XiaoHai11111/FlexGrip/4.Images/DCDC-5v.png

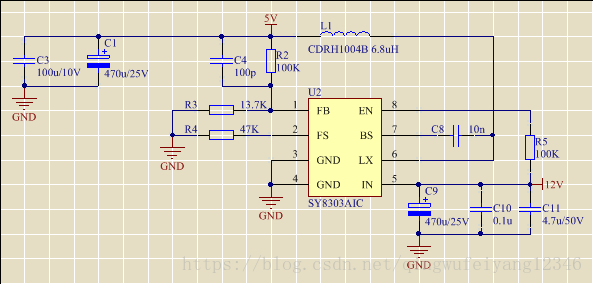
4.Images/DCDC-5v.png
