XiaoHai11111/FlexGrip/4.Images/PCB1.png

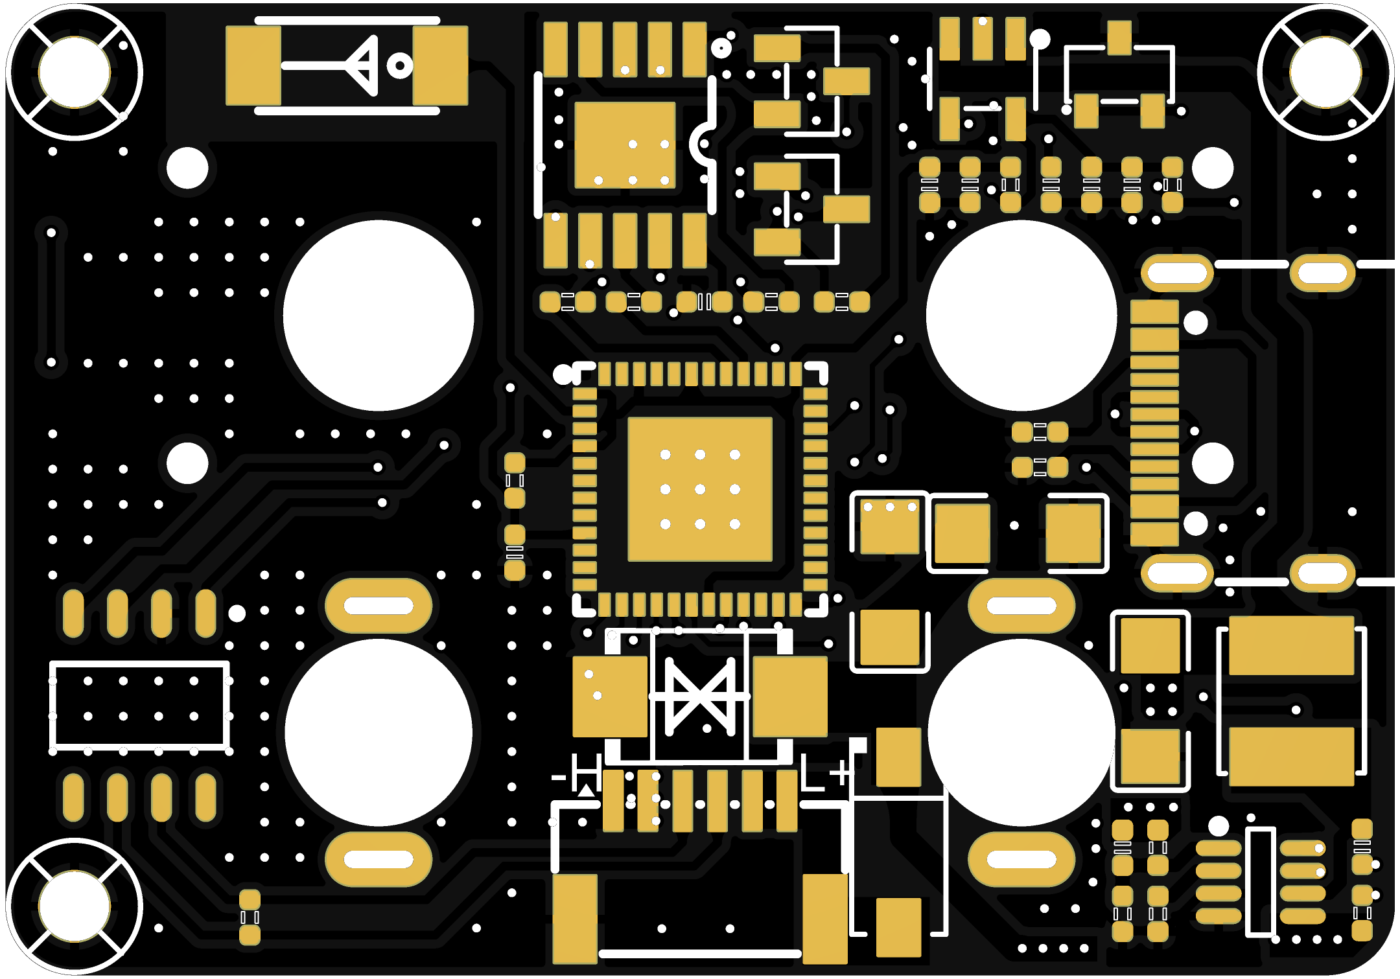
4.Images/PCB1.png
