XiaoHai11111/FlexGrip/4.Images/PCB2.png

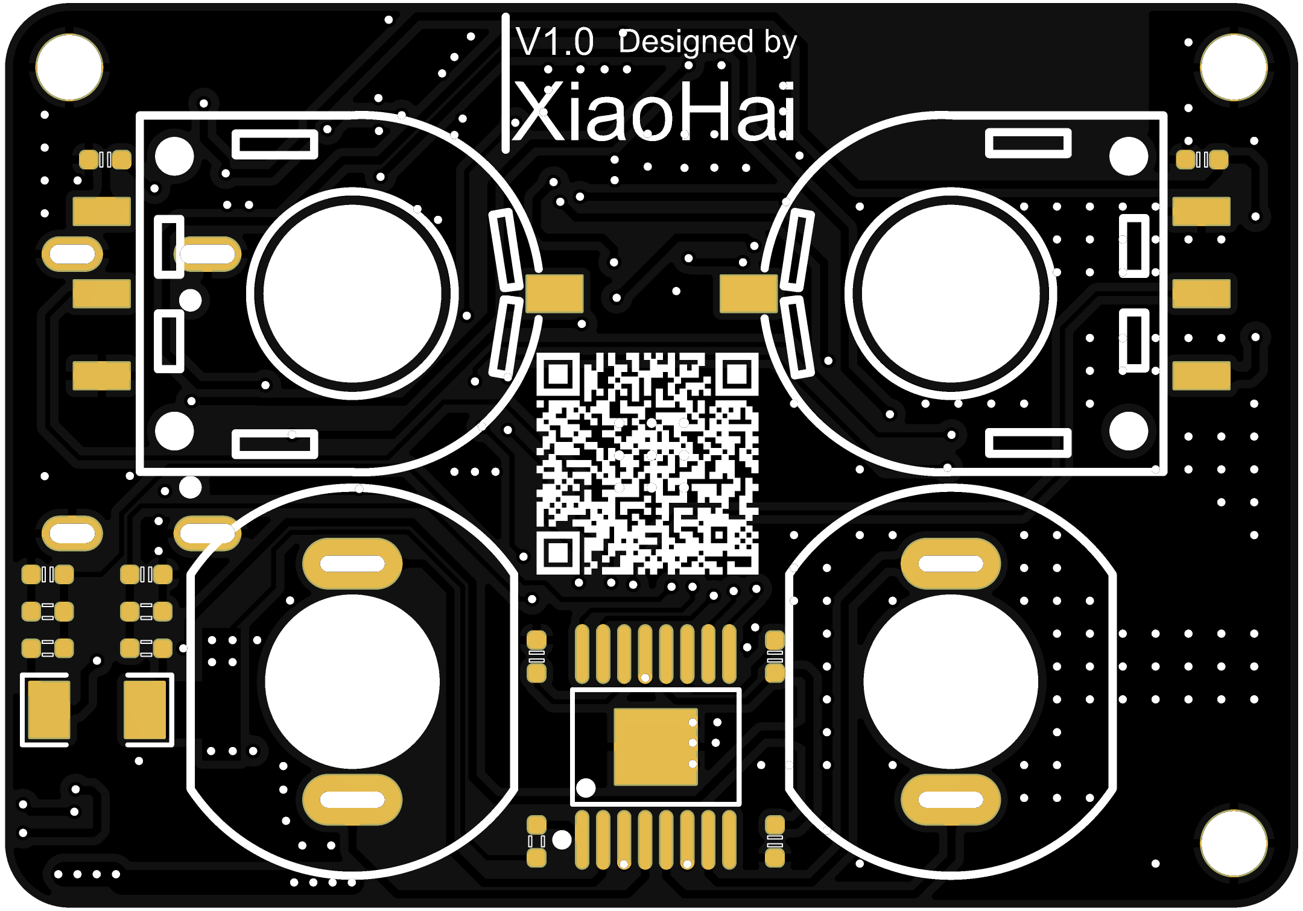
4.Images/PCB2.png
