XiaoHai11111/FlexGrip/1.Model/FlexGrip_URDF/FlexGripper.SLDASM

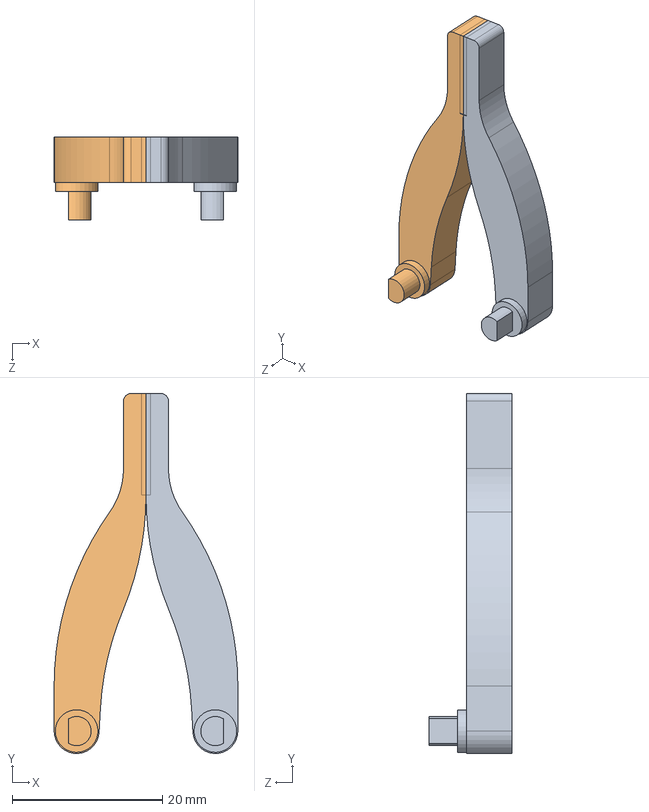
[picture p4: CAD file, 2026-10-30]
1.Model/FlexGrip_URDF/FlexGripper.SLDASM
24.5 x 48.0 x 11.0 mm
FlexGrip_gripper_left
FlexGrip_gripper_right
