XiaoHai11111/FlexGrip/1.Model/FlexGrip_DCBrushedMotor/Self/加工文件/外壳2.STEP

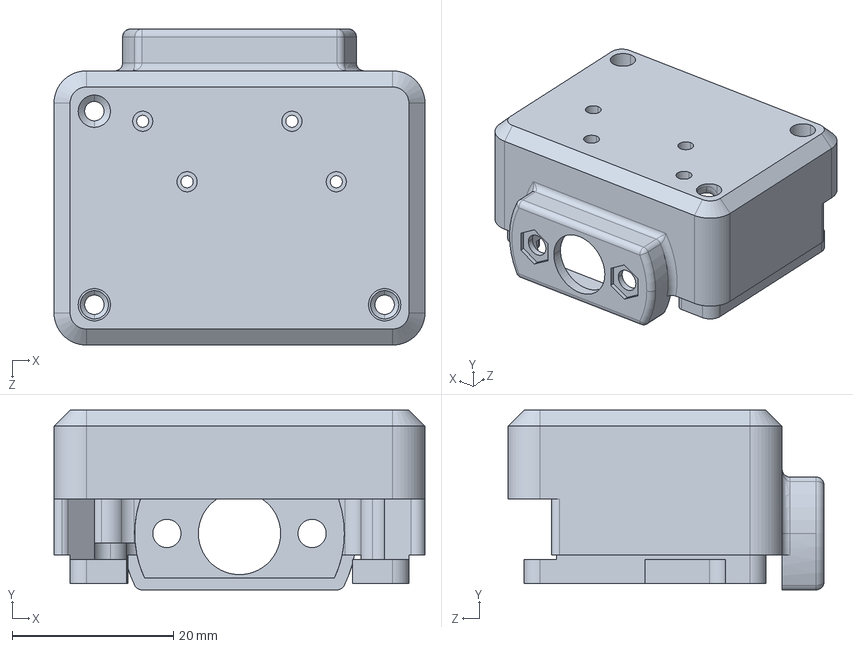
[picture p5: CAD file, 2026-10-30]
1.Model/FlexGrip_DCBrushedMotor/Self/加工文件/外壳2.STEP
46.0 x 22.3 x 39.2 mm
