XiaoHai11111/FlexGrip/1.Model/FlexGrip_URDF/FlexGrip_gripper_right.SLDPRT

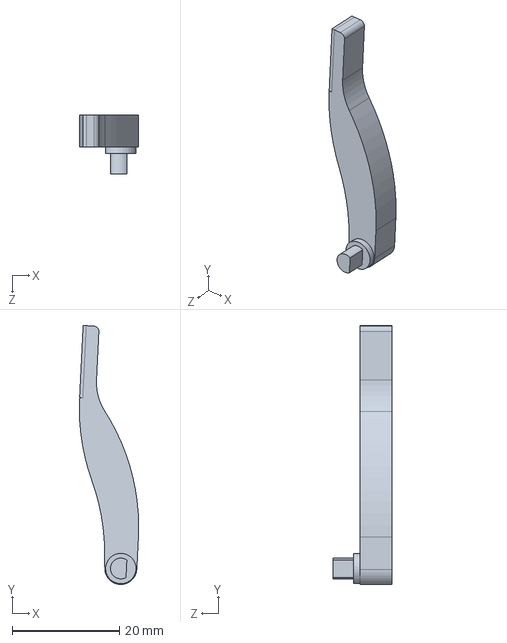
[picture p6: CAD file, 2026-10-30]
1.Model/FlexGrip_URDF/FlexGrip_gripper_right.SLDPRT
11.1 x 48.4 x 11.0 mm
