XiaoHai11111/FlexGrip/6.Software/FlexGripper/meshes/finger_right.STL

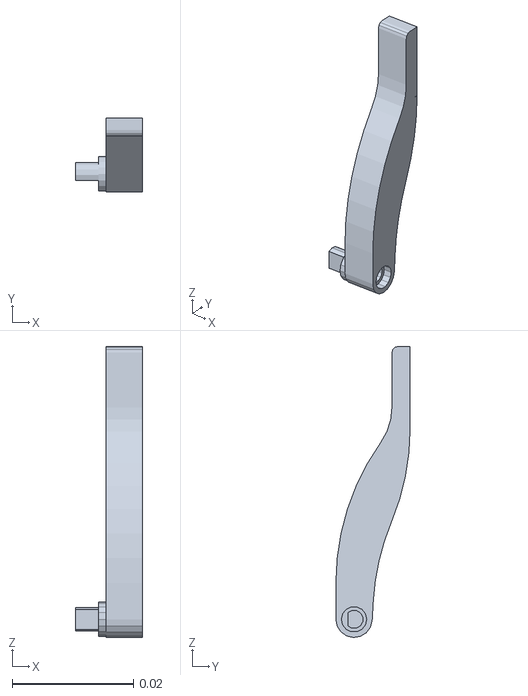
[picture p7: CAD file, 2026-10-30]
6.Software/FlexGripper/meshes/finger_right.STL
0.011 x 0.0123 x 0.048
