XiaoHai11111/FlexGrip/1.Model/FlexGrip_DCBrushedMotor/Self/加工文件/外壳1.STEP

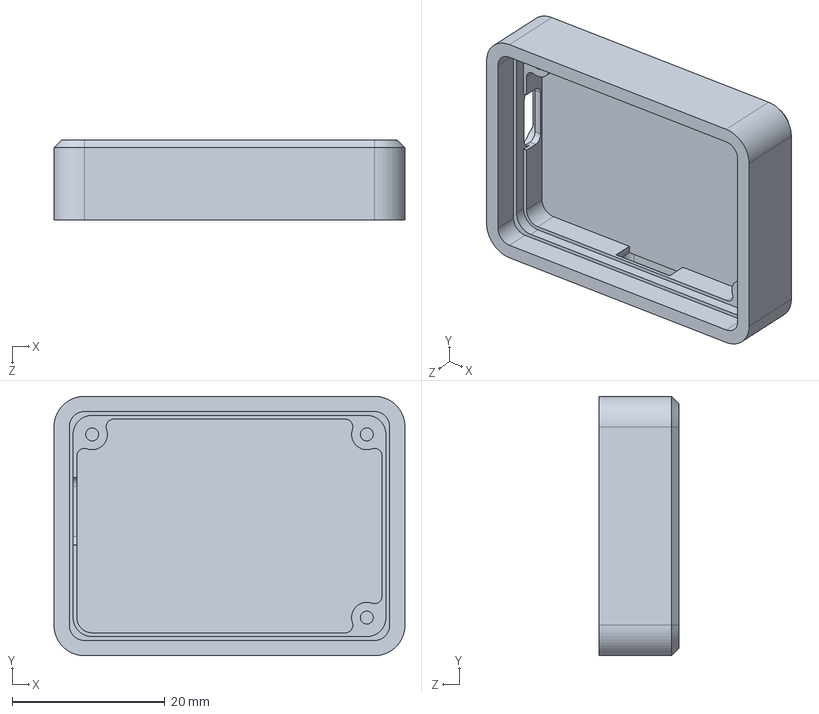
[picture p8: CAD file, 2026-10-30]
1.Model/FlexGrip_DCBrushedMotor/Self/加工文件/外壳1.STEP
46.0 x 34.0 x 10.5 mm
