XiaoHai11111/FlexGrip/1.Model/FlexGrip_DCBrushedMotor/Zhihui/MirrorDCMotor.SLDPRT

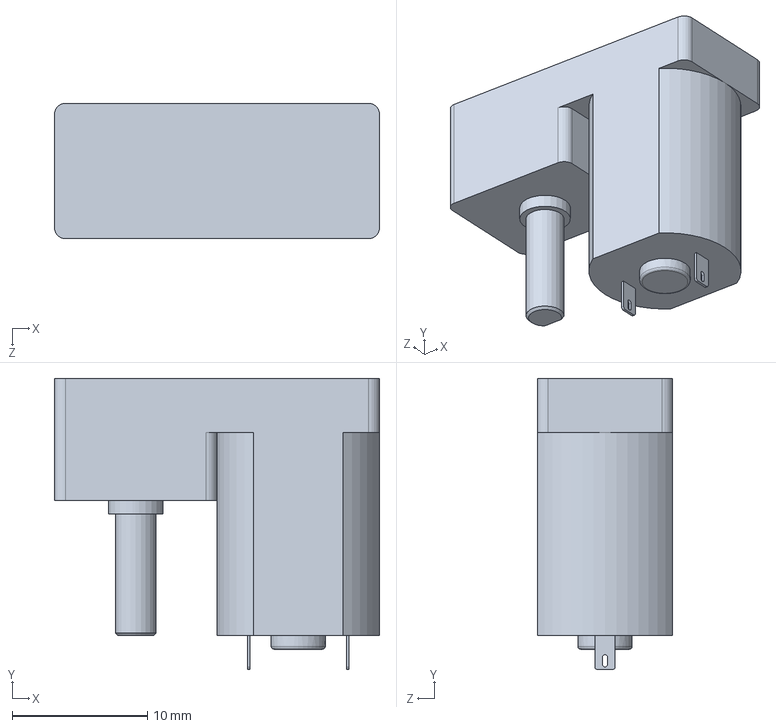
[picture p9: CAD file, 2026-10-30]
1.Model/FlexGrip_DCBrushedMotor/Zhihui/MirrorDCMotor.SLDPRT
24.0 x 21.5 x 10.0 mm
