XiaoHai11111/FlexGrip/6.Software/FlexGripper/meshes/FlexGripper.STL

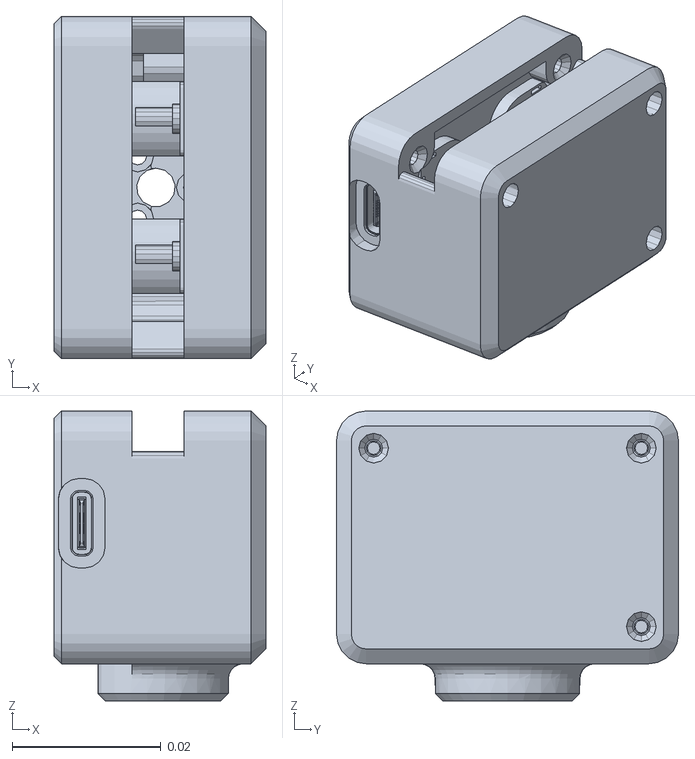
[picture p10: CAD file, 2026-10-30]
6.Software/FlexGripper/meshes/FlexGripper.STL
0.0285 x 0.046 x 0.039
