XiaoHai11111/FlexGrip/1.Model/FlexGrip_URDF/FlexGrip.SLDPRT

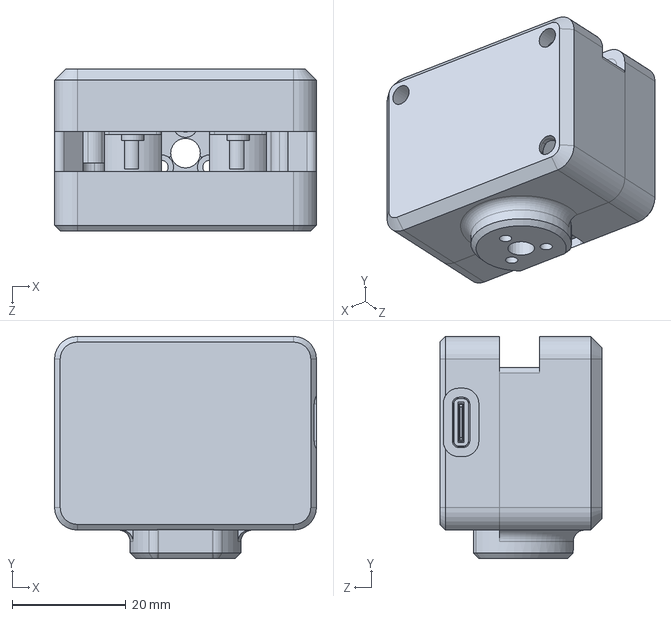
[picture p11: CAD file, 2026-10-30]
1.Model/FlexGrip_URDF/FlexGrip.SLDPRT
46.0 x 39.0 x 28.5 mm
