XiaoHai11111/FlexGrip/1.Model/FlexGrip_DCBrushedMotor/Self/夹爪.SLDPRT

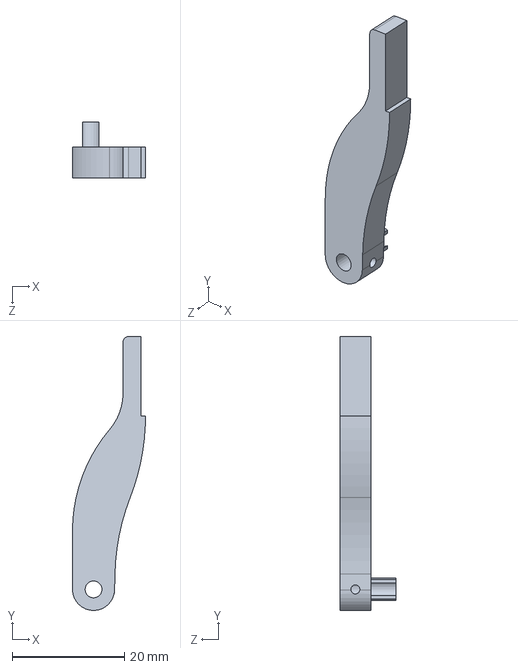
[picture p12: CAD file, 2026-10-31]
1.Model/FlexGrip_DCBrushedMotor/Self/夹爪.SLDPRT
13.0 x 48.7 x 10.0 mm
