XiaoHai11111/FlexGrip/1.Model/FlexGrip_DCBrushedMotor/Self/FlexGrip11.SLDPRT

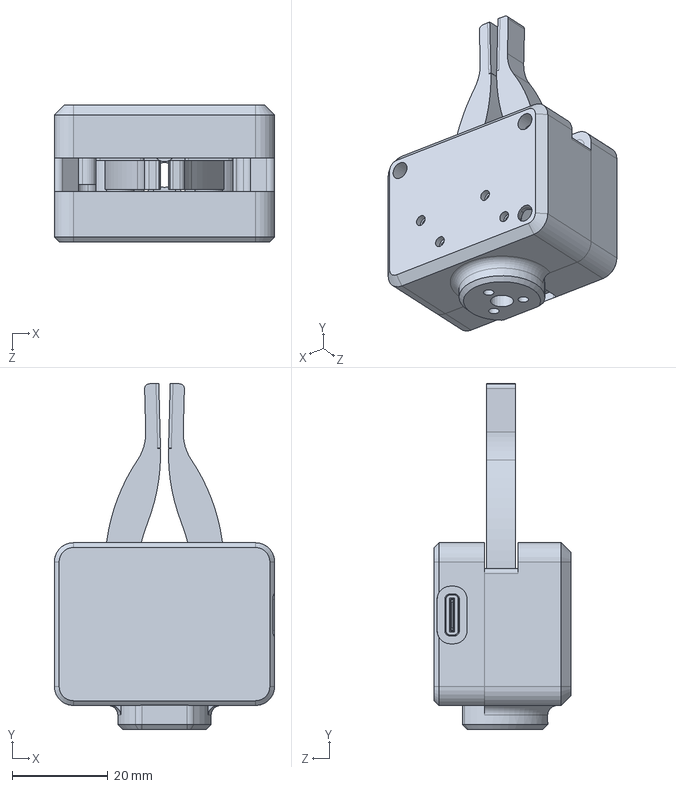
[picture p13: CAD file, 2026-10-30]
1.Model/FlexGrip_DCBrushedMotor/Self/FlexGrip11.SLDPRT
46.0 x 72.2 x 28.5 mm
