XiaoHai11111/FlexGrip/1.Model/FlexGrip_DCBrushedMotor/Self/FlexGrip.SLDPRT

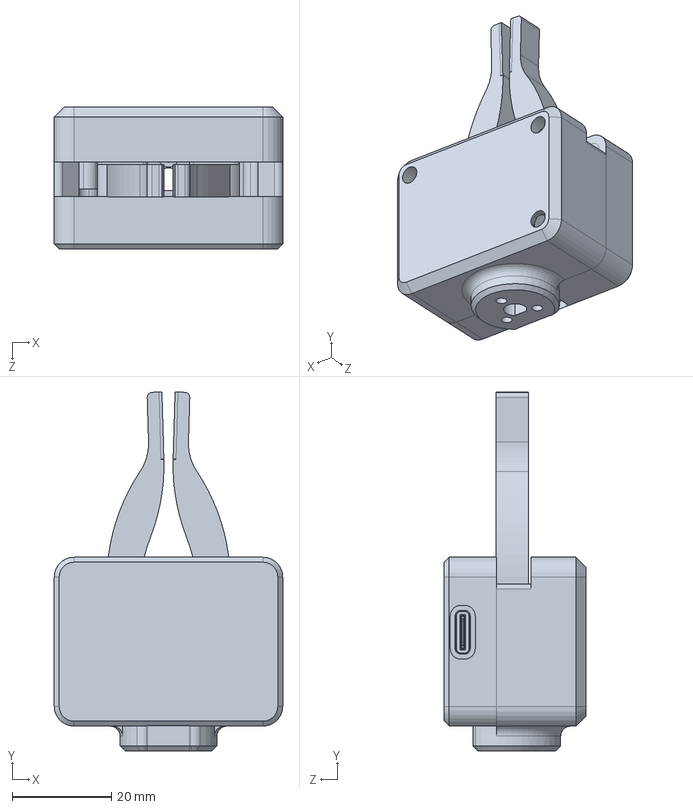
[picture p14: CAD file, 2026-10-30]
1.Model/FlexGrip_DCBrushedMotor/Self/FlexGrip.SLDPRT
46.0 x 72.3 x 28.5 mm
