XiaoHai11111/FlexGrip/1.Model/FlexGrip_DCBrushedMotor/Self/切边导向支座.SLDPRT

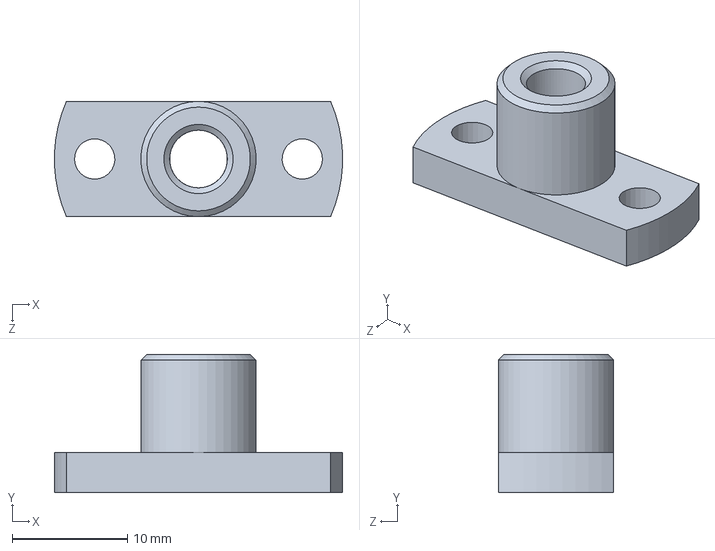
[picture p15: CAD file, 2026-10-30]
1.Model/FlexGrip_DCBrushedMotor/Self/切边导向支座.SLDPRT
25.0 x 12.0 x 10.0 mm
