XiaoHai11111/FlexGrip/1.Model/FlexGrip_DCBrushedMotor/Self/硅胶垫.SLDPRT

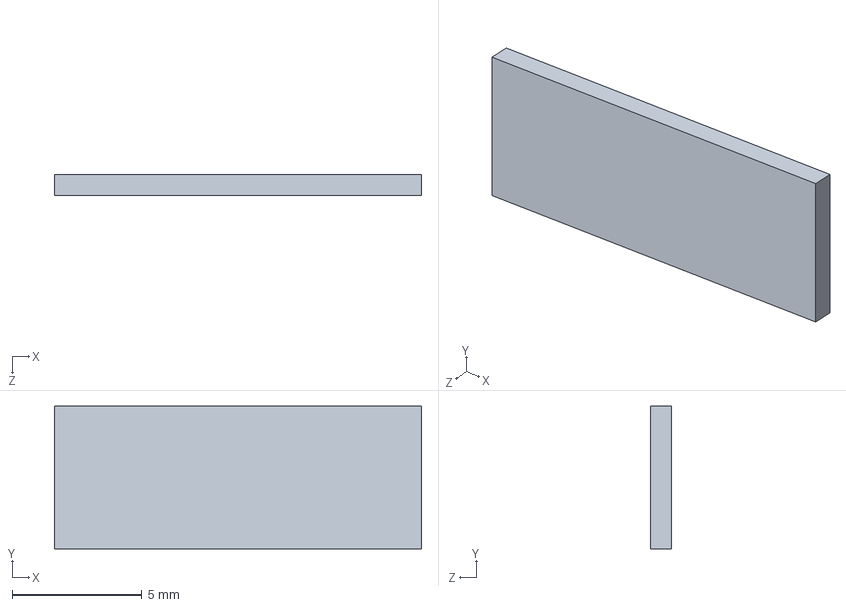
[picture p16: CAD file, 2026-10-30]
1.Model/FlexGrip_DCBrushedMotor/Self/硅胶垫.SLDPRT
14.1 x 5.50 x 0.8 mm
