XiaoHai11111/FlexGrip/1.Model/FlexGrip_DCBrushedMotor/Zhihui/FlexGrip.SLDASM

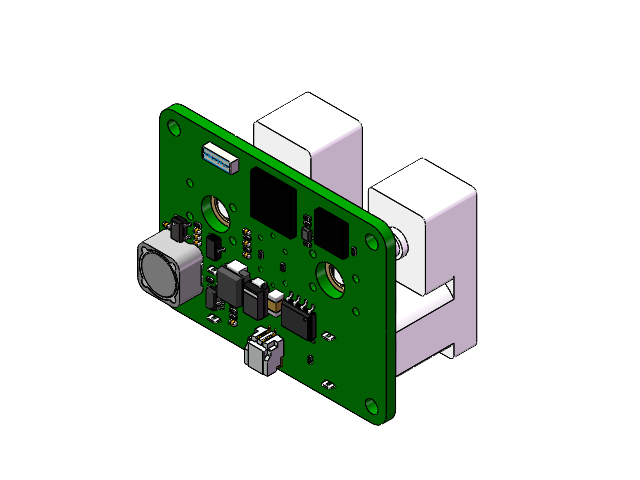
[picture p17: CAD file, 2026-10-30]
1.Model/FlexGrip_DCBrushedMotor/Zhihui/FlexGrip.SLDASM
Mid_Body.step x 3
Mark.step x 3
SOT-23-3.step
pins.step
body.step
top.step
Mid_Body-2.step x 7
Mark-3.step x 7
Mid_Body-5.step x 5
Mark-6.step x 5
Mid_Body-8.step x 2
Mark-9.step x 2
User Library-sot238.step
User Library-SOT23-5-2.step
SW3DPS-SO-8-DEFAULT.step
Extruded.step
_X2_041A043E0440043F04430441_X0_.step
_X2_041C04350442043A0430_X0_.step
_X2_041D043E0436043A0430_X0_.step x 8
321.step
Mid_Body-14.step x 2
Mark-15.step x 2
_________4.step x 2
_________2.step x 2
_________1.step x 2
_________3.step x 2
Trans_Diodes_BC847BVC-7_eec.step
SH03W_KORP.step
SHXX_PIN (1).step
SHXX_PIN_2.step
CD74.step
632722110112_1.step
Body_1.step
Leg.step x 2
User Library-DO-214AC_SMA.step
(___________.step
123.step
DCMotor
MirrorDCMotor
