XiaoHai11111/FlexGrip/1.Model/FlexGrip_DCBrushedMotor/Self/FlexGrip_PCB_Self.SLDASM

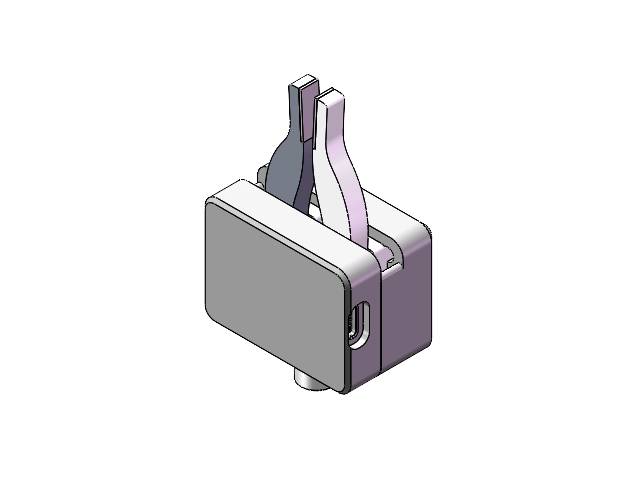
[picture p18: CAD file, 2026-10-31]
1.Model/FlexGrip_DCBrushedMotor/Self/FlexGrip_PCB_Self.SLDASM
RES_0402.step
SOLID.step x 2
SOLID-0.step
COMPOUND.step
COMPOUND-1.step
SOLID-2.step
SOLID-3.step
SOLID-5.step x 18
SOLID-6.step x 3
SOLID-7.step x 16
COMPOUND-8.step
COMPOUND-9.step
COMPOUND-10.step x 2
SOLID-11.step
COMPOUND-12.step
COMPOUND-13.step
SOLID-14.step
COMPOUND-15.step x 2
COMPOUND-16.step
SOLID-17.step
COMPOUND-18.step
Board.step
夹爪
外壳1
外壳2
硅胶垫 x 2
切边导向支座
Mirror夹爪
