XiaoHai11111/FlexGrip/(list of files, cad)

Other CAD files:
1.Model/FlexGrip_DCBrushedMotor/Self/外壳2.SLDPRT
1.Model/FlexGrip_URDF/FlexGrip_gripper_left.SLDPRT
1.Model/FlexGrip_DCBrushedMotor/Self/Mirror夹爪.SLDPRT
1.Model/FlexGrip_DCBrushedMotor/Zhihui/DCMotor.SLDPRT
6.Software/FlexGripper/meshes/finger_left.STL
1.Model/FlexGrip_DCBrushedMotor/Self/外壳1.SLDPRT
