XiaoHai11111/FlexGrip/5.Documents/SCH_Schematic1_2026-10-31.pdf

L2 | AN2051-245 3V³A
ESP32 | Power

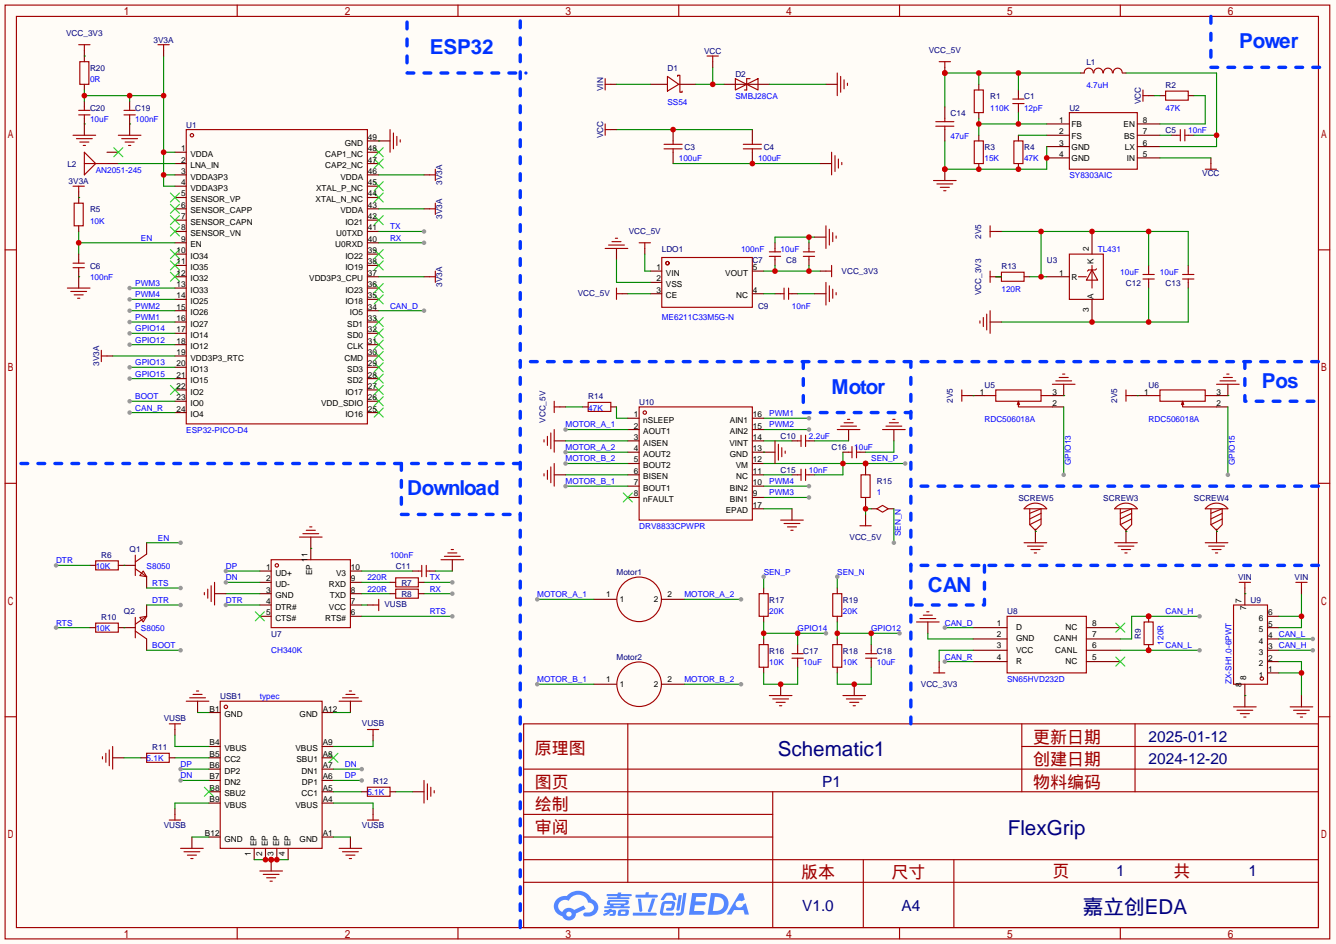
[picture p21: page 1]

PWM1
BIN2 10 NC 11 VM 12 GND 13 VINT 14 AIN2 15 AIN1 16
