XiaoHai11111/FlexGrip/(commit log)

2026-10-30 Feature:实现夹爪0~45°位置闭环控制
    修改描述：
    why: 补齐夹爪位置闭环，支持串口与CAN按0~45控制左右电机
    how: 新增PID与GripControl轨迹控制，补齐双路H桥与串口CAN解析
    影响范围：固件HAL/Ctrl/Config与main、lib/ESP32-CAN、platformio.ini、README.md
2026-10-31 Feature:新增电流环夹持力控制 修改描述： why: 夹爪需按电流控制夹持力度，夹紧碰到物体时恒力限流保护 how: 按1Ω采样电阻计算电流，电流环PI限幅压缩双电机占空比 影响范围：固件HAL/ADC/CAN/Serial、GripControl、Config与README文档
2026-10-31 chore(model): 更新结构模型并删除SolidWorks临时文件
    [FlexGrip_PCB_Self.SLDASM, Mirror夹爪.SLDPRT, 外壳2.SLDPRT, 夹爪.SLDPRT]
2026-10-31 chore: 添加.gitignore忽略SolidWorks临时文件
